kingkong-rc/TINY-TX-X8/README.md

# TINY-TX-X8
kingkong tiny tx x8 radio is a minimalism radio, it's use STM8L052R8(64K/4K) run at 12Mhz, wireless solutions is TI CC2500+CC2592

*************************************************************************
FRSKY-D8/D16(non-EU,international firmware)firmware already release version v1.0, click here https://github.com/kingkong-rc/TINY-TX-X8/releases
*************************************************************************
FRSKY-D8/D16(non-EU,international firmware) 固件已经发布v1.0版本,点击此处 https://github.com/kingkong-rc/TINY-TX-X8/releases
*************************************************************************

*************************************************************************
[FRSKY-D8] frsky d16 code will in this folder
*************************************************************************
[FRSKY-D16] frsky d16 code will in this folder
*************************************************************************
[OFFICIAL FW] folder include the official S-FHSS files.
*************************************************************************
[PDF] folder include manual of x8 radio.
*************************************************************************
[SCH] folder include x8 radio schematic.
*************************************************************************
[TOOLS] folder include the BIN to LDAFW tools and update tools.
*************************************************************************
