kingkong-rc/TINY-TX-X8/SCH/readme

[SCH] folder include x8 radio schematic.
