kingkong-rc/TINY-TX-X8/(threads)

Thread 4 (2018-01-19):

Hi, I tested today and it's works great, thanks.

nigelsheffield, 2018-01-19:
Would it be possible option combine both protocols in one firmware and select them with a gesture at switch on?

LA2003, 2018-01-24:
hi, i will make another D8 FW, but will not make this 3 type protocol together, it's too complex

nigelsheffield, 2018-01-24:
Ok no problem.
I've now flown a quad with this and a frsky xm plus and it seemed quite difficult to control, there seemed to be some lag making acro mode tricky but level mode was fine.
Maybe the d8 version will work better.
On my taranis in d8 mode and hall sensor gimbals there is no problem in acro mode, obviously the gimbals themselves will be a major contributor to this ease of flying on the taranis.

I look forward to trying out the d8 version.
Great work
Thanks.

LA2003, 2018-01-24:
Hi, refresh rate of D16 about 9ms,  I don't think u can feel delay between the TX and FC, if u fly the D16 like this, D8 will the same. There have expo in middle area of  joystick to avoid the errors when joystick back to centre. This will weakens the TX's  centre area respond, I suggest u make same expo compensation for AIL / ELE / ROL channel in BETAFLIGHT around 1400us~1600us, that will speed up the  centre area respond.

nigelsheffield, 2018-01-24:
Right, I did wonder if there was some expo settings used in the tx to compensate for gimbal centering errors.
I will try what you suggest then.
But it might just be best to keep this control for level mode in that case.
Thanks again.

mijo5124, 2020-05-13:
I'd like to figure out how to flash the frsky D16 firmware onto my tiny 8 can someone help me out

KaitlynSeU, 2020-05-18:
@mijo5124
Go to this page : https://github.com/kingkong-rc/TINY-TX-X8/releases
Download files below  [FRSKY ACCST D16 non-EU 2018-01-05-BUILD] tab
you need read [README.docx] first  , the D16 firmware in [FRSKY_D16_80105.zip] use .LDAFW extension.

Flash firmware need use <KINGKONG UPDATE TOOLS.exe>, first time need install X8 radio's driver, the driver files in the bottom row of KINGKONG UPDATE TOOLS's menu, click the <?> icon.

Thread 9 (2018-08-01):

Bind to XM+ fail but bind to XM is success

singlag, 2018-08-01:
I have flashed D16 firmware to my tiny X8, and when binding to XM+, I restart both X8 and Xm+ after the red led flashing (mean binding completed), it show not connected (red led flashing)

doing same thing on XM and it will success (green led), is it a bug ?

KaitlynSeU, 2018-08-10:
make sure your XM and XM+ use D16 non-EU firmware, you can use a X9D or other radio bind XM and XM+ test,   i guess one of them not D16 non-EU firmware.

singlag, 2018-08-19:
update to fcc firmware, it can bind now
but it not stable as xm, sometime got rx error and dosconnect,but xm is rock stable

Thread 10 (2018-08-02):

请问遥控器9/10通道预留焊盘如何使用？

dayue1984, 2018-08-02:
您好，新买了tiny x8，发现后面有个9/10通道焊盘，请问如何扩展？是要焊接个电位器吗？
另外固件方面9/10通道开关地址是多少，固件还应该做哪些修改？
谢谢！

KaitlynSeU, 2018-08-10:
9/10 ch use STM8L052R8's pin37(PB6), buy a BOURNS 3313 10K you can use this channel.

dayue1984, 2018-08-15:
Thank you!

Thread 12 (2018-09-28):

D8 frsky channel 5 & 6 for BNF eachine E500 "mirage"

tripod2, 2018-09-28:
Eachine Mirage E500 Airplane
RTF version: iRangeX iR-i8X Transmitter
https://www.eachine.com/Eachine-Mirage-E500-500mm-Wingspan-Vertical-Lift-Flight-EPP-FPV-Racer-RC-Airplane-p-1047.html
BNF version 🔢  receiver optional - Flysky, Frsky and DSM2 compatible receiver.

i searched for a transmitter with a switch push button for select fly modes trought :hover ;gyro ;3D;
only found ldarc tiny X8 with frsky D8 compatibility
work ok else the problem the 2way switch left button change the fly mode and the three way right switch dont act
it was obivously the 2way for the speed change & the 3way for the fly mode selection
now can just select trought VTOL or 3D modes
the seller who provided both was very fuzzy on the responsibility between items
tought my preference is to keep a vtol

but is it possible to mod the code of D8 firmware for it can match the E500
since i dont found people report using the switch button then im not sure if its a bug or if the plane is responsible
but it seem more possible to change the D8 code than to found a transmitter of the same design(ps2)
duno if i will have to make myself a mod or if its a fix to wait

for the futur i asked if the BNF frsky M620 mirabot of the same design will be compatible with the ldarc tiny X8 and the seller answered than manufacturer said no its not but im not sure if its because i complaint for this actual problem where he certified compatibility
