kingkong-rc/TINY-TX-X8/SCH/X8 mainboard SCH.pdf

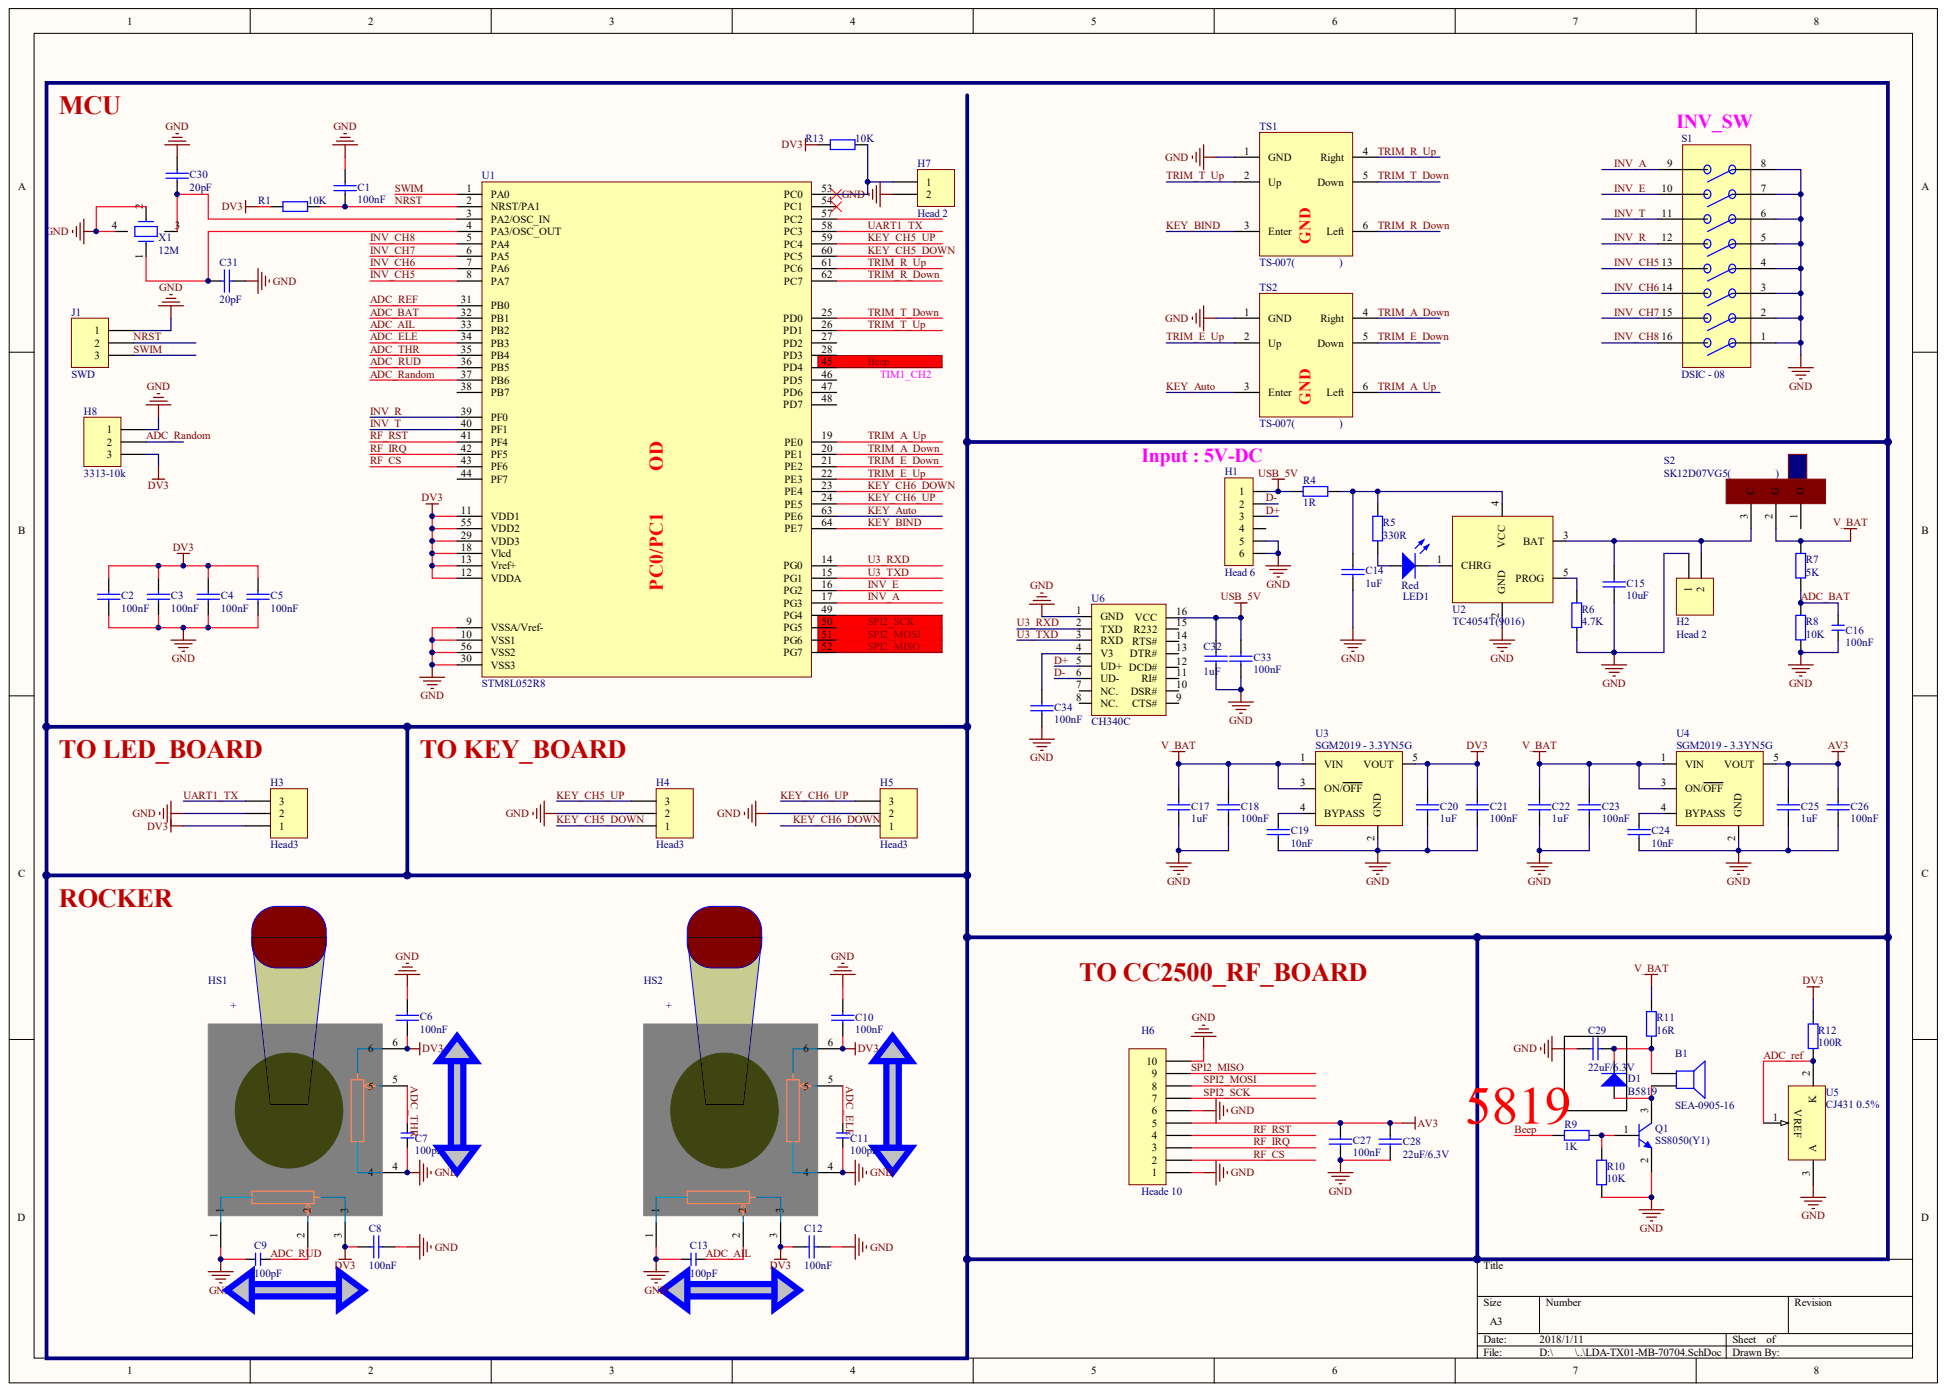
[picture p7: page 1]
