kingkong-rc/TINY-TX-X8/FRSKY-D8/IAR-STM8-210/main.c

/*******************************************************************************
--------------------------------------------------------------------------------
此程序是基于SFHSS(2017-10-25)版本修改而来。
--------------------------------------------------------------------------------
特别注意修改程序时 : 需要修改对应的宏定义(比如 : 软件版本号 / 无线协议版本号   等等....)
--------------------------------------------------------------------------------
*******************************************************************************/
#include "include.h"

void main(void)
{
  	disableInterrupts();
	boot();
	enableInterrupts();
	WatchDog_Init();
	while(1)
	{
	  	//!!!!!!!!!!!!!!!!!!!!!!!!!!!!!!!!!!!!!!!!!!!!!!!!!!!!!!!!!!!!!!
	  	//注意 : 这个 2mS 和实际的 2mS 相差比较大，不能作为精确计数 
	  	//!!!!!!!!!!!!!!!!!!!!!!!!!!!!!!!!!!!!!!!!!!!!!!!!!!!!!!!!!!!!!!
	  	if(tbc_2ms_flag == true)
		{
		  	tbc_2ms_flag = false ;
			FeedTheDog();						//喂狗
			menu();
		}
	}
}
