kingkong-rc/TINY-TX-X8/FRSKY-D8/IAR-STM8-210/stm8l15x_it.c

/**
  ******************************************************************************
  * @file    GPIO/GPIO_Toggle/stm8l15x_it.c
  * @author  MCD Application Team
  * @version V1.3.0
  * @date    07/14/2010
  * @brief   Main Interrupt Service Routines.
  *          This file provides template for all peripherals interrupt service routine.
  ******************************************************************************
  * @copy
  *
  * THE PRESENT FIRMWARE WHICH IS FOR GUIDANCE ONLY AIMS AT PROVIDING CUSTOMERS
  * WITH CODING INFORMATION REGARDING THEIR PRODUCTS IN ORDER FOR THEM TO SAVE
  * TIME. AS A RESULT, STMICROELECTRONICS SHALL NOT BE HELD LIABLE FOR ANY
  * DIRECT, INDIRECT OR CONSEQUENTIAL DAMAGES WITH RESPECT TO ANY CLAIMS ARISING
  * FROM THE CONTENT OF SUCH FIRMWARE AND/OR THE USE MADE BY CUSTOMERS OF THE
  * CODING INFORMATION CONTAINED HEREIN IN CONNECTION WITH THEIR PRODUCTS.
  *
  * <h2><center>&copy; COPYRIGHT 2010 STMicroelectronics</center></h2>
  */

/* Includes ------------------------------------------------------------------*/
#include "include.h"
/** @addtogroup STM8L15x_StdPeriph_Examples
  * @{
  */

/** @addtogroup GPIO_Toggle
  * @{
  */

/* Private typedef -----------------------------------------------------------*/
/* Private define ------------------------------------------------------------*/
/* Private macro -------------------------------------------------------------*/
/* Private variables ---------------------------------------------------------*/
/* Private function prototypes -----------------------------------------------*/
/* Private functions ---------------------------------------------------------*/
/* Public functions ----------------------------------------------------------*/

#ifdef _COSMIC_
/**
  * @brief  Dummy interrupt routine
  * @param  None
  * @retval None
*/
INTERRUPT_HANDLER(NonHandledInterrupt, 0)
{
  /* In order to detect unexpected events during development,
     it is recommended to set a breakpoint on the following instruction.
  */
}
#endif

/**
  * @brief  TRAP interrupt routine
  * @param  None
  * @retval None
*/
INTERRUPT_HANDLER_TRAP(TRAP_IRQHandler)
{
  /* In order to detect unexpected events during development,
     it is recommended to set a breakpoint on the following instruction.
  */
}
/**
  * @brief  FLASH Interrupt routine.
  * @param  None
  * @retval None
  */
INTERRUPT_HANDLER(FLASH_IRQHandler, 1)
{
  /* In order to detect unexpected events during development,
     it is recommended to set a breakpoint on the following instruction.
  */
}
/**
  * @brief  DMA1 channel0 and channel1 Interrupt routine.
  * @param  None
  * @retval None
  */
INTERRUPT_HANDLER(DMA1_CHANNEL0_1_IRQHandler, 2)
{
	//DMA1_CH1_ISR();
}
/**
  * @brief  DMA1 channel2 and channel3 Interrupt routine.
  * @param  None
  * @retval None
  */
INTERRUPT_HANDLER(DMA1_CHANNEL2_3_IRQHandler, 3)
{
  /* In order to detect unexpected events during development,
     it is recommended to set a breakpoint on the following instruction.
  */
}
/**
  * @brief  RTC Interrupt routine.
  * @param  None
  * @retval None
  */
INTERRUPT_HANDLER(RTC_IRQHandler, 4)
{
  /* In order to detect unexpected events during development,
     it is recommended to set a breakpoint on the following instruction.
  */
}
/**
  * @brief  External IT PORTE/F and PVD Interrupt routine.
  * @param  None
  * @retval None
  */
INTERRUPT_HANDLER(EXTIE_F_PVD_IRQHandler, 5)
{
  /* In order to detect unexpected events during development,
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
{
  /* In order to detect unexpected events during development,
     it is recommended to set a breakpoint on the following instruction.
  */
}

/**
  * @}
  */

/**
  * @}
  */

/******************* (C) COPYRIGHT 2010 STMicroelectronics *****END OF FILE****/
