kingkong-rc/TINY-TX-X8/FRSKY-D8/IAR-STM8-210/include.h

#ifndef _INCLUDE_H_
#define _INCLUDE_H_

#include "stm8l15x.h"
#include "stdlib.h"

#include "LED.h"
#include "beep.h"
#include "key.h"
#include "tbc.h"
#include "boot.h"
#include "adc.h"
#include "SPI2.h"
#include "EE.h"
#include "u3.h"
#include "uniqueID.h"

#include "CC2500.h"
#include "FRSKYD8.h"

#include "Menu.h"
#include "PowerOn.h"
#include "StartUp.h"
#include "FTDebug.h"

#endif
